01HACKER01/chaox-75-v1/full keyboard-v1.step

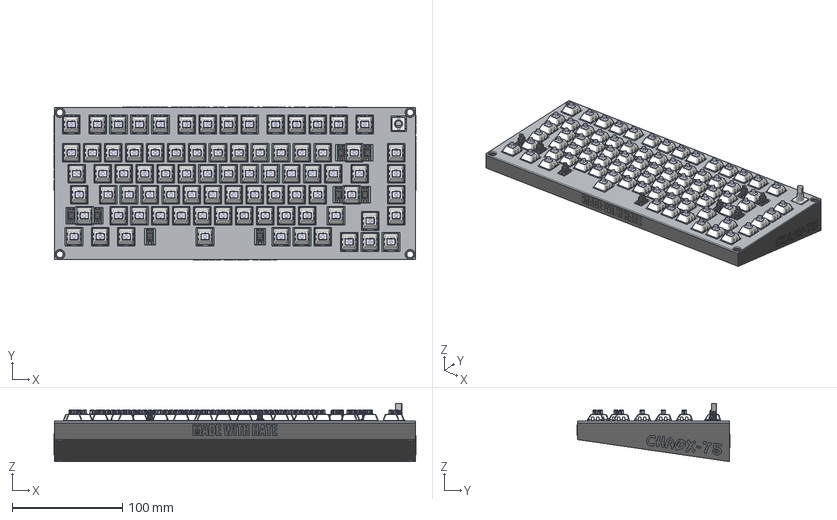
[picture p1: CAD file, 2026-11-05]
full keyboard-v1.step
329.0 x 139.1 x 52.9 mm
TOP CASE001
SW_Hotswap_Kailh_cp x 82
SW_Hotswap_Kailh_cp001 x 82
SW_Hotswap_Kailh_cp002 x 82
Housing x 82
ThickContact x 82
SpringContact x 82
Stem x 82
Lid x 82
Crystal_SMD_3225-4Pin_3.2x2.5mm
R_0603_1608Metric x 6
C_0603_1608Metric x 98
Stabilizer_Cherry_MX_2u_cp x 3
Stabilizer_Cherry_MX_2u_cp001 x 3
Stabilizer_Cherry_MX_2u_cp002 x 3
Stabilizer_Cherry_MX_2u_cp003 x 3
Stabilizer_Cherry_MX_2u_cp004 x 3
QFN-56-1EP_7x7mm_P0.4mm_EP3.2x3.2mm
SW_Push_SPST_NO_Alps_SKRK x 2
SOIC-8_3.9x4.9mm_P1.27mm
ÃÂ½ÃÂªÃÂ±Ã¡ÂÂ«ÃÂ·
ÃÂ½ÃÂªÃÂ±Ã¡ÂÂ«ÃÂ·001
ÃÂ½ÃÂªÃÂ±Ã¡ÂÂ«ÃÂ·002
ÃÂ½ÃÂªÃÂ±Ã¡ÂÂ«ÃÂ·003
ÃÂ½ÃÂªÃÂ±Ã¡ÂÂ«ÃÂ·004
ÃÂ½ÃÂªÃÂ±Ã¡ÂÂ«ÃÂ·005
Stabilizer_Cherry_MX_6_25u_cp
Stabilizer_Cherry_MX_6_25u_cp001
Stabilizer_Cherry_MX_6_25u_cp002
Stabilizer_Cherry_MX_6_25u_cp003
Stabilizer_Cherry_MX_6_25u_cp004
USB_C_Receptacle_16P_TopMnt_Horizontal_GCT_USB4105-xx-A
USB_C_Receptacle_16P_TopMnt_Horizontal_GCT_USB4105-xx-A001
USB_C_Receptacle_16P_TopMnt_Horizontal_GCT_USB4105-xx-A002
USB_C_Receptacle_16P_TopMnt_Horizontal_GCT_USB4105-xx-A003
USB_C_Receptacle_16P_TopMnt_Horizontal_GCT_USB4105-xx-A004
USB_C_Receptacle_16P_TopMnt_Horizontal_GCT_USB4105-xx-A005
USB_C_Receptacle_16P_TopMnt_Horizontal_GCT_USB4105-xx-A006
USB_C_Receptacle_16P_TopMnt_Horizontal_GCT_USB4105-xx-A007
USB_C_Receptacle_16P_TopMnt_Horizontal_GCT_USB4105-xx-A008
USB_C_Receptacle_16P_TopMnt_Horizontal_GCT_USB4105-xx-A009
USB_C_Receptacle_16P_TopMnt_Horizontal_GCT_USB4105-xx-A010
USB_C_Receptacle_16P_TopMnt_Horizontal_GCT_USB4105-xx-A011
USB_C_Receptacle_16P_TopMnt_Horizontal_GCT_USB4105-xx-A012
USB_C_Receptacle_16P_TopMnt_Horizontal_GCT_USB4105-xx-A013
USB_C_Receptacle_16P_TopMnt_Horizontal_GCT_USB4105-xx-A014
USB_C_Receptacle_16P_TopMnt_Horizontal_GCT_USB4105-xx-A015
USB_C_Receptacle_16P_TopMnt_Horizontal_GCT_USB4105-xx-A016
USB_C_Receptacle_16P_TopMnt_Horizontal_GCT_USB4105-xx-A017
USB_C_Receptacle_16P_TopMnt_Horizontal_GCT_USB4105-xx-A018
USB_C_Receptacle_16P_TopMnt_Horizontal_GCT_USB4105-xx-A019
USB_C_Receptacle_16P_TopMnt_Horizontal_GCT_USB4105-xx-A020
USB_C_Receptacle_16P_TopMnt_Horizontal_GCT_USB4105-xx-A021
USB_C_Receptacle_16P_TopMnt_Horizontal_GCT_USB4105-xx-A022
USB_C_Receptacle_16P_TopMnt_Horizontal_GCT_USB4105-xx-A023
USB_C_Receptacle_16P_TopMnt_Horizontal_GCT_USB4105-xx-A024
USB_C_Receptacle_16P_TopMnt_Horizontal_GCT_USB4105-xx-A025
USB_C_Receptacle_16P_TopMnt_Horizontal_GCT_USB4105-xx-A026
USB_C_Receptacle_16P_TopMnt_Horizontal_GCT_USB4105-xx-A027
USB_C_Receptacle_16P_TopMnt_Horizontal_GCT_USB4105-xx-A028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
