01HACKER01/chaox-75-v1/CAD/full case without pcb.step

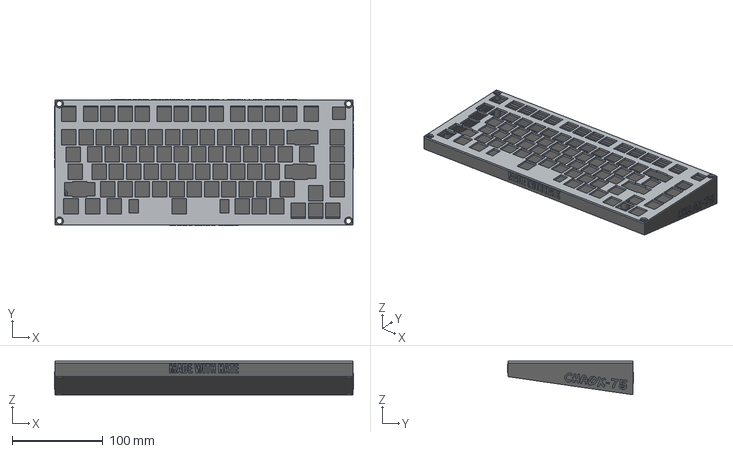
[picture p2: CAD file, 2026-11-05]
CAD/full case without pcb.step
329.0 x 139.1 x 37.0 mm
BOTTOM CASE
TOP CASE
