01HACKER01/chaox-75-v1/CAD/new-case-for-keyboard-BOTTOM CASE.step

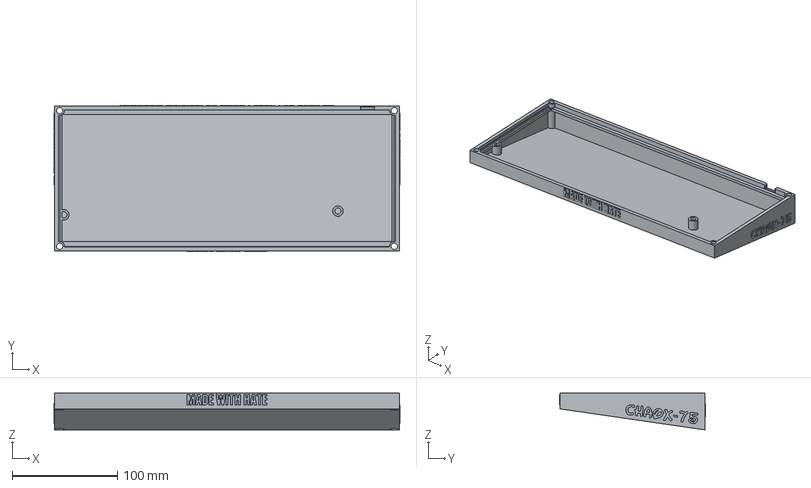
[picture p3: CAD file, 2026-11-05]
CAD/new-case-for-keyboard-BOTTOM CASE.step
329.0 x 139.1 x 35.0 mm
