01HACKER01/chaox-75-v1/PRODUCTION/CHAOX-BOARD.step

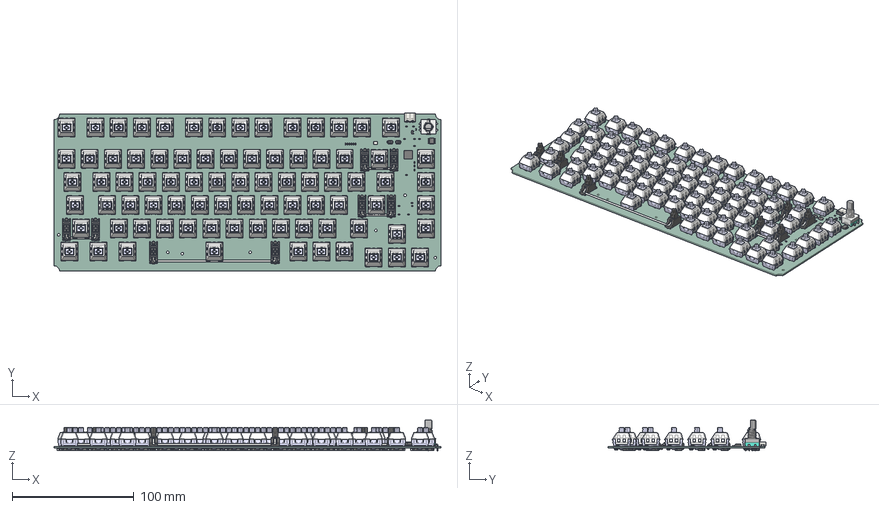
[picture p4: CAD file, 2026-11-05]
PRODUCTION/CHAOX-BOARD.step
318.0 x 130.2 x 25.1 mm
SW_Hotswap_Kailh_cp x 82
Housing x 82
ThickContact x 82
SpringContact x 82
Stem x 82
Lid x 82
Crystal_SMD_3225-4Pin_3.2x2.5mm
R_0603_1608Metric x 6
C_0603_1608Metric x 98
Stabilizer_Cherry_MX_2u_cp x 3
QFN-56-1EP_7x7mm_P0.4mm_EP3.2x3.2mm
SW_Push_SPST_NO_Alps_SKRK x 2
SOIC-8_3.9x4.9mm_P1.27mm
ѽת±ძǷ
Stabilizer_Cherry_MX_6_25u_cp
USB_C_Receptacle_16P_TopMnt_Horizontal_GCT_USB4105-xx-A
SOT-23
D_SOD-123 x 83
CHA2204_PCB
