01HACKER01/chaox-75-v1/CAD/new-case-for-keyboard-TOP CASE.step

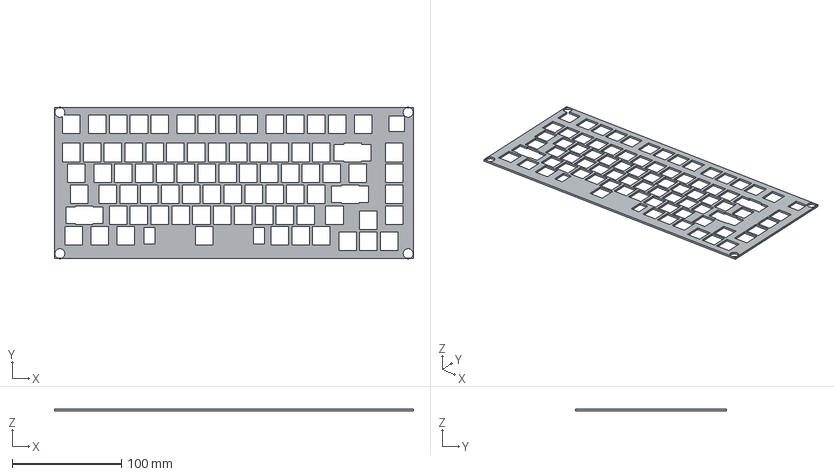
[picture p5: CAD file, 2026-11-05]
CAD/new-case-for-keyboard-TOP CASE.step
328.0 x 138.0 x 2.00 mm
