01HACKER01/chaox-75-v1/FIRMWARE/main.py

print("Starting Chaox Keyboard...")

import board
from kmk.kmk_keyboard import KMKKeyboard
from kmk.keys import KC
from kmk.scanners import DiodeOrientation
from kmk.extensions.peg_rgb_matrix import RGBLight
from kmk.modules.encoders import EncoderHandler

keyboard = KMKKeyboard()

# 1. Matrix Pin Configuration (RP2040 GPIOs matching your KiCad schematic)
keyboard.col_pins = (
    board.GP0,  board.GP1,  board.GP2,  board.GP3,  board.GP4, 
    board.GP5,  board.GP6,  board.GP7,  board.GP8,  board.GP9, 
    board.GP10, board.GP11, board.GP12, board.GP13, board.GP14
)
keyboard.row_pins = (
    board.GP16, board.GP17, board.GP18, board.GP19, board.GP20
)
keyboard.diode_orientation = DiodeOrientation.COL2ROW

# 2. Rotary Encoder Configuration (EC11)
encoder_handler = EncoderHandler()
keyboard.modules.append(encoder_handler)

encoder_handler.pins = (
    (board.GP22, board.GP23, None), # Pin A, Pin B, optional push switch
)
encoder_handler.map = [
    ((KC.VOLD, KC.VOLU),), # Counter-clockwise (Volume Down), Clockwise (Volume Up)
]

# 3. Per-Key RGB LED Configuration (SK6812 MINI-E)
rgb_ext = RGBLight(
    pixel_pin=board.GP21,
    num_pixels=82,
)
keyboard.extensions.append(rgb_ext)

# 4. Keymap Layout (75% 82-Key)
keyboard.keymap = [
    [
        KC.GESC, KC.F1,   KC.F2,   KC.F3,   KC.F4,   KC.F5,   KC.F6,   KC.F7,   KC.F8,   KC.F9,   KC.F10,  KC.F11,  KC.F12,  KC.MUTE, KC.MPLY,
        KC.GRV,  KC.N1,   KC.N2,   KC.N3,   KC.N4,   KC.N5,   KC.N6,   KC.N7,   KC.N8,   KC.N9,   KC.N0,   KC.MINS, KC.EQL,  KC.BSPC, KC.HOME,
        KC.TAB,  KC.Q,    KC.W,    KC.E,    KC.R,    KC.T,    KC.Y,    KC.U,    KC.I,    KC.O,    KC.P,    KC.LBRC, KC.RBRC, KC.BSLS, KC.PGUP,
        KC.CAPS, KC.A,    KC.S,    KC.D,    KC.F,    KC.G,    KC.H,    KC.J,    KC.K,    KC.L,    KC.SCLN, KC.QUOT,          KC.ENT,  KC.PGDN,
        KC.LSFT,          KC.Z,    KC.X,    KC.C,    KC.V,    KC.B,    KC.N,    KC.M,    KC.COMM, KC.DOT,  KC.SLSH, KC.RSFT, KC.UP,   KC.END,
        KC.LCTL, KC.LGUI, KC.LALT,                   KC.SPC,                             KC.RALT, KC.MO(1),KC.LEFT, KC.DOWN, KC.RGHT
    ]
]

if __name__ == '__main__':
    keyboard.go()
